vaaane/horta-inteligente/(commit log)

2026-09-28 Adiciona clima do Open-Meteo: ESP32 -> Firebase -> site
    - teste-acende.ino reorganizado em funções, sem delay(), e consulta
    o Open-Meteo a cada 30 min (5 min se falhar), gravando em /clima
    - Cartão "Clima agora" na teste.html
    - Regras: nó /clima (leitura e escrita abertas, com validação)
2026-09-28 Corrige aviso de formato no log de heap do clima
    [teste-acende.ino]
2026-09-28 Adiciona LEDs de status (Wi-Fi, Firebase, Clima) no teste-acende
    LEDs nos GPIO 25, 26 e 27 com 4 estados (apagado, pisca lento,
    aceso, pisca rápido), piscando com millis() e teste de 1 s no boot.
2026-09-28 Adiciona botão físico do LED e log detalhado de erro do Firebase
    - Botão no GPIO 32 (INPUT_PULLUP, debounce de 50 ms) alterna o LED
    do site e grava em /teste/led; sem Wi-Fi fica pendente e reenvia
    a cada 10 s, sempre o último estado
    - Serial e botão usam o mesmo atualizarLed()
    - gravarNoFirebase() mostra caminho, código e motivo do erro;
    o log do clima mostra o código HTTP
2026-09-29 Leva o cartão Clima agora para o painel (módulo clima.js)
    O código do cartão sai do teste.html e vai para web/clima.js, usado
    nas duas páginas. No painel aparece a faixa informativa de chuva alta
    (>= 60%) e a mensagem de previsão indisponível quando /clima está vazio.
2026-09-29 Adiciona a página Sobre o projeto
    Abertura, fluxo Sensores -> ESP32 -> Firebase -> Painel, cartões de
    funcionalidades gerados a partir de uma lista em sobre.js, tabela de
    materiais e custos, evolução do projeto e seção da equipe.
2026-09-29 Adiciona QR code "Abra no seu celular"
    Gerado no navegador com qrcode-generator (versão fixa no jsDelivr),
    em SVG. No painel só aparece em telas a partir de 1024px; na página
    Sobre aparece sempre, no fim da página.
2026-09-29 Ajusta o painel para tela grande e projetor
    A partir de 1400px: letras maiores, painel com até 1400px de largura e
    umidade, bomba, clima e QR numa linha só. Entre 1024 e 1399px os quatro
    cartões ficam dois por linha.
2026-09-29 Ajusta o painel: clima mais largo, endereço no QR e cartões vazios
    - Cartão Clima agora: valor e unidade não quebram (unidade em <small>),
    rótulos curtos e, a partir de 1024px, cartão largo com os 4 valores
    numa linha.
    - QR code mostra o endereço por extenso; em localhost ou arquivo local
    mostra um aviso no lugar.
    - Umidade e bomba mostram "Aguardando o ESP32…" até chegar o 1º dado.
2026-09-29 Regras: decisão e motivo no estado e histórico em horta/decisoes
    - horta/estado aceita os campos opcionais decisao (lista fechada de
    códigos) e motivo (até 160 caracteres).
    - horta/decisoes: histórico, escrita só do ESP32, indexado por ts.
    - /teste e /clima continuam iguais.
2026-09-29 Firmware da horta: previsão de chuva na decisão da rega
    - Traz do teste-acende a consulta ao Open-Meteo (30 min, 5 min se
    falhar) e grava em /clima com o login do ESP32. Não consulta com a
    bomba ligada, para não atrasar a segurança do tempo máximo.
    - controlarBomba() agora calcula um código de decisão e um motivo em
    português: adia a rega com chance de chuva >= 60%, rega mesmo assim
    com solo abaixo de 20% e rega só pelo sensor sem previsão válida.
    - Envia decisao/motivo em /horta/estado e registra cada mudança de
    código em /horta/decisoes (fila de um item se estiver sem Wi-Fi).
    - SIMULAR_CHANCE_CHUVA para testar em casa.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
2026-09-29 Painel: cartão "Por que regou (ou não)"
    Novo módulo web/decisao.js (mesmo padrão do clima.js): mostra o ícone e
    o motivo da decisão atual do ESP32 em letra grande e as 5 últimas
    decisões de horta/decisoes ("hoje 17:05", "ontem 06:40"). O cartão
    fica escondido se o estado não tiver decisão (firmware antigo).
    Na página Sobre, "Adiar a rega se vai chover" e "Motivo de cada
    decisão" passam para Funcionando.
2026-09-29 Firmware: comandos a cada 3 s, limite de 10 min no manual e Wi-Fi mais estável
    - Montagem de teste com LED no lugar do relé e potenciômetro no lugar do sensor
    - Lê /horta/comandos a cada 3 s reaproveitando a conexão HTTPS com o banco
    - Envia o estado na hora quando a bomba ou a decisão mudam
    - Modo manual volta sozinho para o automático depois de 10 min
    - Wi-Fi: reconexão automática, 30 s antes de recomeçar e motivo das quedas
2026-09-29 Painel: controle da bomba (Automático | Manual e Ligar/Desligar)
    - Módulo novo web/controle.js dentro do cartão "Bomba d'água"
    - O círculo continua mostrando o estado real enviado pelo ESP32
    - Aviso de pedido pendente, sem resposta em 15 s e pausa de segurança
    - Contagem regressiva do modo manual e botões desativados com o ESP32 offline
2026-09-29 README e Sobre: controle pelo site e montagem de teste com LED e potenciômetro
2026-09-29 Regras: UID do ESP32
2026-09-29 Firmware: comandos por streaming e envios mais rápidos
    - Comandos do site por streaming (Server-Sent Events) numa conexão só para
    isso, lida sem travar o loop(); plano B com polling a cada 1 s
    - Sensor a cada 300 ms no MODO_TESTE
    - Estado na hora quando a bomba, a decisão ou a umidade (2 pontos) mudam,
    no máximo 1 por segundo, e a cada 5 s sem mudança
    - Histórico a cada 10 s no MODO_TESTE; campo modoTeste no estado
    - Serial mostra o motivo de cada acionamento e cada comando recebido
2026-09-29 Painel: modo teste, resposta em 5 s e legenda do pedido
    - Offline depois de 20 s sem estado no modo teste (2 min no normal)
    - "O ESP32 não respondeu" depois de 5 s
    - Selo "Modo teste" e sem contagem do manual quando o ESP32 avisa
    - Legenda "Você pediu: ligada/desligada" abaixo do botão
    - README: seção sobre o MODO_TESTE e o streaming
2026-09-29 Firmware: LEDs de status e bomba no GPIO 33
2026-09-29 Firmware: corrige LEDs de status do Wi-Fi e do Firebase
    - DEBUG_LEDS: mostra no Serial cada mudança de LED e, a cada 5 s, o estado
    guardado, o nível real do pino (GPIO.out) e a volta mais lenta do loop()
    - Confere se os GPIO 25/26 continuam como saída digital (não RTC/DAC) e
    reconfigura se algo mexeu neles
    - LEDs fixos têm o pino reescrito a cada 0,5 s
    - Estado dos LEDs sincronizado depois do teste de 1 s do setup()
    [esp32-horta.ino]
2026-09-29 Firmware: modo demonstração (chance de chuva simulada pelo site)
    - Lê simularChuva de /horta/comandos no streaming e no plano B
    - Prioridade: simulação do site, SIMULAR_CHANCE_CHUVA, previsão real;
    motivo termina com "(simulado)"
    - Decide e envia o estado na hora quando a simulação muda
    - No automático, para a rega se a chuva ficar provável (adiada_chuva)
    - Fora do MODO_TESTE a simulação expira em 15 min
    - gravarModoAutomatico usa PATCH para não apagar a simulação
2026-09-29 Painel: cartão Modo demonstração (simular chuva)
    - Módulo novo web/demo.js, acima do "Por que regou (ou não)"
    - Chave Simular chuva, controle de 0 a 100% (grava ao soltar), botões
    rápidos e marcação em 60%
    - Faixa âmbar com "Voltar à previsão real" e linha no cartão do clima
    - Controles desativados com o ESP32 offline
2026-09-29 Firmware: registra cada rega em /horta/regas (água estimada)
    - VAZAO_L_MIN = 1,5 L/min (estimativa; comentário de como medir)
    - Ao desligar a bomba: segundos, litros, motivo e inicio/fim pelo relógio
    do Firebase (vem no ts de cada envio do estado)
    - Fila de até 5 regas para quando estiver sem Wi-Fi
    - Regas com menos de 1 s não são registradas
2026-09-29 Regras: horta/regas (escrita do ESP32) e horta/config/inicioMedicao (aberto)
2026-09-29 Painel: cartão Água (usada e economizada, estimativa)
    - Módulo novo web/agua.js, abaixo do gráfico
    - Água usada, quanto um timer fixo teria usado e a economia (L e %),
    traduzida em banhos e garrafões; diferença negativa mostrada com honestidade
    - Selo Estimativa, rega em andamento com o tempo correndo, 10 últimas regas
    - Zerar contagem com confirmação no próprio cartão (horta/config/inicioMedicao)
    - decisao.js exporta quando() para o formato das datas
2026-09-29 Painel: água ao vivo em passos de 0,5 L
    - A rega em andamento soma na Água usada a cada segundo; ao terminar, fica
    na conta até o registro chegar em /horta/regas (sem pular nem contar duas vezes)
    - Litros na tela arredondados para baixo ao meio litro (Água usada, timer,
    economia, banhos e garrafões); no Firebase continuam com 2 casas
    - Timer fixo começa na primeira rega, fechada ou em andamento
    - "N regas + 1 em andamento"
    - Firmware manda regaDesde no estado (hora do servidor em que a bomba ligou);
    regras liberam o campo
    [esp32-horta.ino]
2026-09-29 Firmware e regras: resumo diário da água em /horta/agua/dias
    - Hora certa por NTP (Brasília); horaValida() e dataHoje()
    - Cada rega soma litros, segundos e regas no dia (PATCH com os totais);
    ET0 do dia vinda do Open-Meteo
    - Ao ligar e ao trocar de dia, lê o dia para continuar de onde parou
    - Rega que atravessa a meia-noite conta no dia em que terminou
    - Regras: horta/agua/dias/$dia (AAAA-MM-DD), escrita só do ESP32
2026-09-29 Painel: água por dia (gráfico e tabela)
    - Gráfico de barras no cartão Água: usado pela horta, timer fixo e
    recomendado pela ET0 (et0 × AREA_M2 = 0,25 m²), com 7 | 14 | 30 dias
    - A barra de hoje soma as regas de hoje e a rega em andamento, ao vivo
    - Frase-resumo do período (economia negativa dita com honestidade)
    - Tabela recolhível por dia com rolagem própria; valores de 0,5 em 0,5 L
    - Dias sem registro contam 0 L de uso (o timer continua contando)
2026-09-29 Regras: horario_quente nas listas de decisão, simularHora e estado/hora
2026-09-29 Painel: simular horário, ícone do sol forte e hora da horta
    - Modo demonstração: chave Simular horário (0 a 23 h, grava ao soltar),
    faixa laranja "sol forte" das 10h às 16h, botões 07h, 12h e 17h e faixa
    âmbar com Voltar ao horário real; demo.js monta as duas simulações a
    partir de uma configuração
    - Ícone ☀️ para horario_quente
    - "Hora da horta: 14h (simulada)" no cabeçalho do painel
    - Sobre: Horário inteligente -> Funcionando
2026-09-29 Regras: cota_atingida nas listas de decisão, zerarCotaEm e cota no estado
2026-09-29 Painel: barra da cota pela ET0, recomeçar a cota e ícone 🎯
    - Cartão Água: "Cota de hoje pela ET₀" com barra de progresso (sobe ao
    vivo com a bomba ligada) e a conta ET₀ × área × Kc
    - Modo demonstração: botão Recomeçar a cota (demo) -> zerarCotaEm
    - Ícone 🎯 para cota_atingida
    - Sobre: Quanto regar pela ET₀ -> Funcionando
2026-09-29 Firmware: cota desconta a chuva que caiu
    - Open-Meteo: precipitation_sum do dia -> chuvaHojeMm (também em /clima)
    - cota = max(0, ET0 × Kc − chuva) × área
    - Com cota 0 pela chuva: "Choveu X mm hoje: mais que a planta perdeu."
    - Regras de /clima aceitam chuvaHojeMm
2026-09-29 Firmware: margem extra de até 50% quando o solo continua seco
    - MARGEM_EXTRA = 0,5: com a cota atingida e o solo ainda precisando de
    água, libera rega extra (decisão nova cota_extra) até cota × 1,5
    - Passou da margem: cota_atingida pedindo para conferir sensor e canteiro
    - litrosExtra (acima da cota) guardado no resumo do dia e lido ao ligar
    - et0Pendente vira resumoPendente
2026-09-29 Firmware: detecção de falha (regou e a umidade não subiu)
    - Depois de 45 s de rega automática, a umidade tem que ter subido 3 pontos;
    senão desliga, entra em falha (decisão nova falha_agua) e registra
    - Em falha o automático não liga, nem com solo crítico; o manual obedece
    - Sai pelo "Já resolvi" do site (resetFalhaEm) ou se a umidade subir 10 pontos
    - Chave detectarFalha do site (ausente = ligada) para as demonstrações
    - emFalha no estado e em /horta/agua/ajuste (vale depois de reiniciar)
    - Ordem da decisão comentada no código (1 a 10)
    [esp32-horta.ino]
2026-09-29 Firmware: aprende com os dias (ajuste do Kc)
    - KC vira o valor inicial; o kc em uso fica em /horta/agua/ajuste
    (kc, motivo, atualizadoEm) e é lido ao ligar
    - Na virada do dia: usou margem extra sem falha -> kc + 0,1 (teto 1,5);
    usou menos de 70% da cota sem crítico nem falha -> kc - 0,05 (piso 0,6)
    - Resumo do dia grava kc, cota, chuvaMm e litrosExtra
    - simularFimDiaEm do site aplica o ajuste com os números de hoje e
    recomeça a cota
2026-09-29 Regras: cota_extra e falha_agua, comandos da falha e do Kc, ajuste e campos do dia
    - cota_extra e falha_agua em todas as listas de decisão
    - horta/comandos: resetFalhaEm, simularFimDiaEm (<= now) e detectarFalha
    - horta/estado/emFalha
    - horta/agua/ajuste (só o ESP32): kc 0,6 a 1,5, emFalha, atualizadoEm, motivo
    - horta/agua/dias aceita kc, cota, chuvaMm e litrosExtra
2026-09-29 Painel: margem extra, Kc aprendido, falha e fim do dia simulado
    - Barra da cota até 150%: verde até a cota, margem extra listrada; a conta
    (ET₀ × Kc − chuva) × área e a linha do Kc (ajustado quando e por quê)
    - Faixa vermelha de falha no topo e no cartão da bomba, com Já resolvi
    (módulo novo web/falha.js)
    - Ícones ⚠️ (falha_agua) e ➕ (cota_extra)
    - Modo demonstração: Simular fim do dia e a chave Detectar falha
    - Gráfico: barra da ET₀ usa a cota salva no dia; a dica mostra ET₀, chuva e Kc
    - Sobre: Detecção de falhas -> Funcionando
2026-09-29 Firmware: corrige conexão Wi-Fi (motivo 3)
    - A autocorreção dos LEDs não reconfigura mais o GPIO 25/26 pelo RTC/DAC
    (rtc_gpio_deinit a cada 0,5 s): são pinos do ADC2, usado pelo Wi-Fi.
    Agora só avisa no Serial; a reescrita do nível a cada 0,5 s continua
    - configTime (NTP) só depois que o Wi-Fi conecta
    [esp32-horta.ino]
2026-09-29 Firmware: explica o motivo 3 de queda do Wi-Fi
2026-09-29 Firmware: histerese no solo crítico
    - Crítico entra abaixo de 20% e só sai acima de 25% (emCritico); entre
    20% e 25% continua regando com motivo próprio; depois de sair, a cota ou
    a margem que parou a rega não recomeça por oscilação de 1 ponto
    - Umidade com média móvel das últimas 5 leituras
    - Decisão automática não troca o estado da bomba mais de uma vez a cada 3 s
    (manual, falha e comandos do site continuam na hora)
    - Histórico: decisão só vai para /horta/decisoes depois de 10 s estável;
    A→B→A em menos de 10 s não gera entradas
2026-09-29 Planeje sua horta: desenho do terreno
    - Página nova web/planejar.html e link na navegação do painel e da Sobre
    - web/planejar.js: terreno em escala num canvas (régua e grade de 1 m,
    nítido em telas de alta densidade), seta do norte que gira (arrastando ou
    pelo controle), local (latitude/longitude)
    - Obstáculos retângulo (muro, casa) e círculo (árvore) com altura: adicionar,
    arrastar com mouse ou dedo (Pointer Events), editar e excluir no painel
    - Exemplo pronto (muro de 2 m no norte, árvore de 4 m no leste), salvamento
    no localStorage e Começar do zero
2026-09-29 Planeje sua horta: mapa de horas de sol
    - web/sol.js: cálculo puro (quadradinhos de 0,25 m, maiores acima de ~4000),
    posição do sol pelo SunCalc a cada 30 min do nascer ao pôr, conversão do
    azimute do SunCalc (a partir do sul) para o desenho, sombra por interseção
    com retângulos e círculos (altura > d × tan(altitude)), ano todo = menor valor
    - Mapa de calor com legenda (sombra, meia-sombra, pleno sol) em cores boas
    para daltônicos; dica "5,5 h de sol" com mouse ou toque
    - Datas: dia escolhido, Hoje, Verão, Inverno, Equinócio e Ano todo (pior caso)
    - Recalcula sozinho com um pequeno atraso; mostra "calculando…" se demorar
    - web/sol.test.mjs: testes em Node (node web/sol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
2026-09-29 Planeje sua horta: plantas e o melhor lugar para cada uma
    - web/culturas.js: sol e umidade de referência de 11 plantas e a escolha do
    lugar (as mais exigentes primeiro, região contínua crescendo a partir do
    melhor ponto, meia-sombra evita gastar os pontos de pleno sol)
    - "O que você quer plantar?" com a área de cada planta; regiões coloridas
    com o nome no mapa e explicação em texto (lado, horas de sol, falta de sol
    ou de espaço), respeitando a data ou o ano todo
    - Tabela "Umidade e sol por cultura" com a explicação de pleno sol,
    meia-sombra e sombra
    - Teste da sugestão em web/sol.test.mjs
2026-09-29 Planeje sua horta: Sobre e README
    - Sobre: Desenhe sua horta, Mapa de horas de sol, Melhor lugar para cada
    planta e Umidade e sol por cultura -> Funcionando; Sol suficiente ou não e
    Previsto × medido continuam Próxima etapa, com a nota do cálculo já pronto
    - README: seção Planeje sua horta (o cálculo em 4 passos e o roteiro da
    feira) e os arquivos novos na lista
2026-09-29 Planeje sua horta: mapa de satélite
    - Módulo novo web/mapa.js: Leaflet 1.9.4 (cdnjs) com as imagens Esri World
    Imagery (sem chave), maxNativeZoom 19 e maxZoom 21, atribuição da Esri e
    camada de nomes de ruas opcional; começa em São Sebastião (DF), zoom 17
    - Busca de endereço pelo Nominatim (uma busca por clique, com atribuição)
    e "Usar minha localização" com mensagem clara se a pessoa negar
    - Alternância Sobre o mapa | Desenho livre no topo da página
    - Desenho livre não mede nem desenha enquanto está escondido
2026-09-29 Planeje sua horta: desenhar sobre o mapa
    - Terreno desenhado no mapa (clicar e arrastar, ou um toque para 6 × 4 m),
    com alças para redimensionar, mover e girar, e as medidas em metros
    - Obstáculos: casa ou muro (retângulo, com giro) e árvore (círculo); tipos
    sugeridos casa térrea 3 m, sobrado 6 m, muro 2 m e árvore média 5 m
    - Gestos próprios com mouse ou dedo: o mapa só anda quando o toque começa
    fora dos desenhos e sem ferramenta
    - Mesmo painel de edição do Desenho livre; no mapa o norte é sempre para
    cima (rosa dos ventos fixa) e o cálculo usa o centro do terreno
    - Ajuda da ferramenta por cima do mapa, sem empurrar a página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
2026-09-29 Planeje sua horta: cálculo e mapa de calor sobre o satélite
    - O desenho do mapa vira metros num plano local centrado no terreno
    (1° de latitude ≈ 111 320 m; longitude × cos(latitude)); a grade segue o
    terreno mesmo girado, e o giro do terreno vira o ângulo do norte do plano
    - sol.js: campo opcional angulo nos retângulos (casas giradas em relação ao
    terreno); sem ele a conta é a mesma. Teste novo em sol.test.mjs
    - Mapa de calor semitransparente só dentro do terreno (opacidade de 30% a
    90%), mesma legenda, dica "5,5 h de sol" com mouse ou toque
    - Regiões sugeridas para cada planta desenhadas sobre o mapa com o nome;
    datas, ano todo, plantas e textos iguais ao Desenho liv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
2026-09-29 Planeje sua horta: salvar e compartilhar
    - Salva no navegador (localStorage, em try/catch) o modo, o centro e o zoom
    do mapa, o terreno e os obstáculos
    - Copiar link: o desenho (e as plantas marcadas) vai no endereço (#p= com
    JSON compacto em base64); quem abre vê a mesma horta. Sem permissão para
    copiar, mostra o link para copiar à mão
    - Carregar exemplo no modo mapa: terreno 6 × 4 m no centro do mapa, muro de
    2 m no norte e árvore de 5 m no canto leste
    - A página abre no modo Sobre o mapa (Desenho livre se o mapa não carregar)
2026-09-29 Planeje sua horta: textos do modo mapa
    - Explicação na página: o cálculo pela posição do sol a cada 30 minutos,
    a sombra pela altura dos obstáculos e para que serve a imagem de satélite
    - README: seção do modo Sobre o mapa, com as atribuições (Esri,
    OpenStreetMap/Nominatim, Leaflet) e o roteiro da feira
2026-09-29 Planeje sua horta: arrastar a região de cada planta
    - Módulo novo web/plantas.js (os dois modos usam o mesmo código): cada
    planta vira um canteiro retangular alinhado à grade, com a área escolhida
    - Arrastar pela região ou pelo nome (mouse e dedo); ao soltar, encaixa na
    grade; no modo mapa o mapa não anda enquanto a planta é arrastada
    - Botão ↻ gira 90° (tenta um pouco para os lados se não couber)
    - Fora do terreno ou sobre obstáculo: cinza tracejado com "Aqui não dá";
    ao soltar num lugar inválido, volta para o último lugar válido
    - culturas.js: tamanho do canteiro (área exata quando dá, ex. 4 × 2),
    validação, melhor posição e sugestão; avaliação do lugar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
2026-09-29 Planeje sua horta: avaliação ao vivo de cada planta
    - Canteiro pintado pela avaliação do lugar (verde Recomendado, amarelo
    Aceitável, vermelho Não recomendado), com borda e preenchimento
    semitransparente e o ícone ✓ ! ✕ junto do nome
    - Balão de texto durante o arraste e na planta tocada, ex.: "Tomate aqui:
    4,5 h de sol (mín. 2,5 h). Precisa de 6 h ou mais. Não recomendado.";
    meia-sombra também avisa quando passa do máximo
    - Reavalia quando mudam a data (ou ano todo), os obstáculos e o terreno
    - Lista com o selo da avaliação, as horas de sol e o lugar; se nem o melhor
    lugar serve, explica o que fazer
2026-09-29 Planeje sua horta: convivência entre plantas
    - Sobreposição: contorno vermelho nas duas regiões e o aviso "Tomate e
    Alface estão no mesmo lugar." (também ao vivo durante o arraste)
    - Rega: vizinhas a menos de 0,5 m com faixas de umidade sem parte em comum
    (encostar só na borda também conta) ganham uma dica amarela, sem mudar a
    cor da avaliação de sol
2026-09-29 Planeje sua horta: nomes legíveis, botões e resumo das plantas
    - Região pequena na tela (lado menor que ~40 px) ou lugar já ocupado: o nome
    sai para fora com uma linha fina, testando posições em volta até achar uma
    livre (os nomes não se sobrepõem mais)
    - Botões Voltar à sugestão (planta selecionada) e Sugerir de novo (todas)
    - Mostrar só as áreas boas para…: pinta de verde os pontos recomendados
    para a planta escolhida (cinza no resto), nos dois modos
    - Resumo acima da lista: "3 plantas recomendadas, 1 aceitável, 1 não
    recomendada."
    - Medidas dos canteiros arredondadas (sem 1.2000000000000002)
2026-09-30 Planeje sua horta: desenho da planta
    - planta.js desenha a planta num canvas próprio, sem a imagem de satélite:
    terreno em escala com o norte para cima (girado se estiver girado no mapa),
    grade de 1 m, medidas nos lados, mapa de horas de sol, obstáculos com nome
    e altura, plantas com a cor e o ícone da avaliação (nomes fora com linha),
    rosa dos ventos, escala gráfica, cabeçalho, legenda e rodapé
    - legenda e mapa com padrões (sombra hachurada, meia-sombra pontilhada) para
    imprimir em preto e branco
    - convivência entre plantas separada em convivenciaEntre(), usada também
    pela planta
2026-09-30 Planeje sua horta: Minhas hortas
    - campo "Nome do projeto" (padrão "Minha horta"), usado no título da
    planta e no nome dos arquivos
    - "Salvar projeto" guarda no navegador uma lista de projetos (nome, data,
    todos os dados e uma miniatura); com o mesmo nome, atualiza
    - lista "Minhas hortas" com miniatura, nome e data, e os botões Abrir,
    Renomear, Duplicar e Excluir (com confirmação na própria linha)
    - projetos salvos e arquivos guardam as coordenadas sem arredondar:
    abertos de novo, as horas de sol e as avaliações ficam iguais
2026-09-30 Hortas na nuvem: regras do Firebase
    - /hortasPlanejadas: ninguém lista todas as hortas (.read false); quem sabe
    o código abre e altera a sua
    - código no formato certo, nome de 1 a 60 caracteres, dados até 300000,
    datas não podem estar no futuro, editor até 40, arquivada booleana,
    versões só nas gavetas "0" a "9", nenhum campo a mais
    - não dá para apagar: ".write" exige newData.exists() (o Firebase não roda
    ".validate" quando o dado é apagado, por isso a condição fica no .write)
2026-09-30 Hortas na nuvem: salvar, abrir e continuar
    - "Salvar na nuvem": na primeira vez cria o código e mostra um quadro com
    o código grande, o link (planejar.html?h=...), o QR code, o botão Copiar
    e o aviso "Anote este código..."; depois salva na mesma horta
    - salvamento automático 3 s depois de parar de mexer, com o indicador
    (Salvo na nuvem ✓ / Salvando… / Sem conexão: envio quando voltar)
    - histórico: uma versão a cada "Salvar" e a cada 5 min de edição (as 10
    últimas); restaurar guarda antes a atual, para poder desfazer
    - abrir pelo campo "Tenho um código" ou pelo link ?h=; código que não
    existe mostra "Não encontrei uma horta com esse código."
    - edição ao mesmo t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
2026-09-30 Hortas na nuvem: Minhas hortas com códigos
    - a lista deste aparelho guarda códigos: nome, código, último acesso e
    miniatura de cada horta criada ou aberta aqui (a aberta fica destacada)
    - botões Abrir e Tirar da lista (só esquece o código neste aparelho; a
    horta continua na nuvem)
    - aviso: "Esta lista fica só neste aparelho. Em outro aparelho, abra pelo
    código ou link."
    - projetos antigos, salvos só no navegador, aparecem à parte com
    "Enviar para a nuvem" (cria um código para cada um), Abrir e Excluir
    - sai o botão "Salvar projeto" local; Copiar link e Arquivo do projeto
    continuam
2026-09-30 Planeje sua horta: histórico de versões mais claro
    - não grava versão igual à mais recente (salvar manual, automática de
    5 min e "antes de restaurar")
    - no máximo uma versão por minuto pelo "Salvar na nuvem": outro clique
    dentro de 60 s troca a versão desse minuto
    - cada versão guarda um resumo ("Terreno 6 × 4 m · 2 obstáculos ·
    3 plantas (...)") com o que mudou ("+ Pimenta", "Tomate movido",
    "− Árvore", "Terreno redimensionado") e o tipo (salva por você,
    automática, antes de restaurar); regras liberam resumo e tipo
    - lista "Versões desta horta": linha "Atual" no topo, data com segundos,
    etiqueta, frase explicando que são da mesma horta (com o código) e a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
2026-09-30 Planeje sua horta: arquivo .json vira backup no menu
    - sai o botão "Abrir arquivo" da barra principal; entra "Abrir pelo
    código", que mostra o campo do código (o mesmo de antes, sem duplicar)
    - menu "Salvar planta ▾": Imagem (PNG), Imprimir / PDF e, na parte
    "Backup", Baixar backup (.json) e Abrir backup (.json), com a ajuda
    "Backup é uma cópia da horta no seu computador..."
    - abrir backup com uma horta da nuvem aberta pergunta: horta nova (sem
    código, o padrão) ou substituir a atual (que vai para o histórico)
    - textos: "Arquivo do projeto" vira "backup" (tela e README)
2026-09-30 Telegram: fila e envio
    - sendMessage (HTML, sem prévia de link) para cada chat id da lista,
    numa conexão própria (abre, envia, fecha), timeout de 8 s
    - fila de até 8 mensagens (a mais antiga sai se encher); o loop() envia
    uma por vez, no máximo a cada 3 s: quem decide só põe na fila
    - sem Wi-Fi a fila espera; mensagem com mais de 10 min é descartada
    - 429 respeita o retry_after; 400/401/403 avisam no Serial e desligam o
    Telegram até reiniciar; erro de rede tenta de novo em 30 s
    - pouca memória para mais uma conexão segura: espera
2026-09-30 Telegram: quais mensagens
    - avisos pela decisão estável (a que vai para /horta/decisoes depois de
    10 s): rega começou, adiada/interrompida (🌧️ ☀️ 🎯), solo crítico,
    falha, manual e volta ao automático
    - rega terminou (tempo e litros); rega de menos de 20 s vira uma
    mensagem só ("💧 Regou 15 s")
    - falha resolvida, placa ligada e resumo do dia na virada (regas,
    litros, cota, Kc antes → depois e o timer fixo de comparação)
    - MODO_TESTE: só os importantes, a não ser com
    TELEGRAM_TUDO_NO_MODO_TESTE
    - anti-spam: a mesma mensagem (evento + código) não se repete antes de
    60 s; motivos escapados para HTML; link do painel no fim
    - README: tabela das mensagens e r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
    [esp32-horta.ino]
2026-09-30 Telegram: aviso de horta sem sinal como próxima etapa
    - README: passos para um Worker separado com Cron Trigger (5 min) que
    lê horta/estado/ts e avisa uma vez "sem sinal" e depois "voltou",
    com o estado num KV e o token em secret do Worker
    - não implementado agora: precisa criar e publicar Worker e KV novos
    na conta do Cloudflare
2026-09-30 Telegram: "Alertas no celular" funcionando no site
    - sobre.js: status muda de "próxima" para "funcionando"
    - nada do token nem dos chat ids vai para o site
2026-09-30 Pode regar agora: semáforos no estado
    - /horta/estado passa a mandar o que a decisão considerou: emCritico,
    chanceUsada (-1 sem previsão), chuvaSimulada, horaSimulada,
    cotaLimite (cota + margem extra), detectarFalha e bloqueio
    - bloqueio: o que impediria a rega agora se o solo precisasse
    ("", falha, chuva, horario, cota, chuva_caiu), na mesma ordem de
    controlarBomba() e sem contar o solo crítico
    - o estado vai na hora quando o bloqueio muda
    - regras: campos novos opcionais, com tipos e faixas
2026-09-30 Pode regar agora: faixa no topo do painel
    - web/podeRegar.js: faixa logo abaixo dos cartões do topo, acima do
    Modo demonstração
    - linha 1, a resposta: modo manual, regando agora, não precisa regar,
    "⛔ Não vai regar — (bloqueio)", "🚨 Regando mesmo assim — solo
    crítico… Sem o crítico, a chuva impediria." e "Sem dados do ESP32"
    - linha 2, os semáforos (solo, chuva, horário, cota, falha) com ícone,
    valor, cor e "(simulado)"; o que bloqueia vai primeiro, com borda
    grossa; tocar num chip mostra a explicação de uma linha
    - botão ao lado do bloqueio: Recomeçar a cota (demo), Já resolvi ou
    Voltar ao real, usando as funções de demo.js e falha.js
    - o site não re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
2026-09-30 Pode regar agora: legível no projetor e no celular
    - celular: chips em duas colunas, o texto quebra em vez de ser cortado;
    o botão de ação ocupa a linha inteira
    - projetor (≥ 1400px): resposta e chips maiores
    - estado nunca só pela cor: ícone e texto sempre visíveis, e o leitor
    de tela ouve "liberado/atenção/bloqueando"
2026-09-30 Site: canal do Telegram (QR no projetor, botão no celular)
    - web/config.js: CANAL_TELEGRAM, o único lugar com o link do canal
    (só o link público; nada de token ou chat id no site)
    - painel, tela grande: cartão "Abra no seu celular" com dois QR lado
    a lado (📱 Abrir o painel e 🔔 Receber alertas), ocupando 2 colunas;
    o do canal aparece até no localhost
    - painel, celular: botão "🔔 Receber alertas no Telegram" logo abaixo
    da faixa "Pode regar agora?", com a frase sobre o canal
    - Sobre: "Entrar no canal" e QR pequeno (tela grande) no item
    "Alertas no celular"
    - rodapé de todas as páginas: "Alertas no Telegram"
    - qr.js: o endereço embaixo do QR pode quebrar depois da "/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
2026-10-01 Painel: cabeçalho compacto
    - uma linha só nas 3 páginas: 🌱 Horta Inteligente e a escola em texto
    pequeno à esquerda, navegação à direita (de ~170 px para ~60 px)
    - "Hora da horta" vira uma pílula ao lado do nome ("🕐 15h")
    - celular (≤ 600 px): a navegação vira o botão ☰ (cabecalho.js, com
    aria-expanded; Esc e toque fora fecham). Sem JavaScript a lista
    continua visível
2026-10-01 Painel: abas
    - abas Agora · Água · Histórico · Demonstração (abas.js), cada uma com
    endereço próprio (#agora, #agua, #historico, #demo); trocar de aba
    muda o hash sem recarregar; role=tablist/tab/tabpanel, setas e
    Home/End; os módulos continuam todos ligados com a aba escondida
    - Agora: faixa "Pode regar agora?" no topo (QR ao lado no computador),
    4 cartões (umidade com tracinhos em liga 35% / desliga 60%, bomba,
    clima compacto e o novo "Água economizada", que abre a aba Água) e a
    linha "Última decisão, 11:31: … ver histórico"
    - o motivo grande repetido sai: "Últimas decisões" vai para o Histórico
    - Água: "Em coisas do dia a dia" em linhas separadas, sem "0,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
2026-10-01 Painel: modo projetor
    - projetor.js: com ?tela=projetor ou o interruptor da aba Demonstração
    (guardado no localStorage), alterna Agora → Água → Histórico a cada
    20 s; a Demonstração nunca entra na rotação
    - fica parado na aba Agora enquanto há falha, a bomba está ligada ou a
    decisão acabou de mudar (30 s); um toque, clique ou tecla pausa por
    2 min
    - três pontinhos discretos no canto mostram a aba no ar (laranja =
    pausado)
    - para caber sem rolar a partir de 1024 px: cartões mais justos, aba
    Água em duas colunas (números e gráfico por dia), Histórico com o
    gráfico e as decisões lado a lado; no projetor em 720 p, gráficos
    mais baixos e sem as notas pequen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
2026-10-01 Painel: correções visuais
    - pílula "Desligada/Ligada 💧" da bomba limitada à largura do cartão
    (max-width e quebra; fonte menor na tela grande)
    - títulos dos cartões numa linha só: menos espaço entre letras e fonte
    menor na fileira de 4 cartões
    - cartões da mesma fileira com a mesma altura e o conteúdo no topo
    - rodapé do painel e do Planeje sua horta sem o link "Página de teste"
    (teste.html continua no endereço direto)
2026-10-01 Painel: canal do Telegram no lugar do QR do site
    - quem olha o projetor já está vendo o site: o cartão "Abra no seu
    celular" vira "Receba os alertas da horta", com o QR do canal, a
    frase "Avisos de rega, falha e reservatório no seu celular" e o @ do
    canal; no celular, o botão "Abrir canal no Telegram" no lugar do QR
    - config.js: TELEGRAM_CANAL (antes CANAL_TELEGRAM) é o único lugar com
    o link; vazio, o cartão e os links do canal não aparecem
    - o QR do site continua só na página Sobre
    - modo projetor: o pontinho acompanha a aba na mesma hora da troca; em
    720 p a faixa, os chips e os números da aba Agora ficam um pouco
    menores para caber sem rolar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
2026-10-01 Painel: README
    - seção "O painel": abas e o #hash de cada uma, quem pode mexer
    (tela grande ou ?demo=1), modo projetor (?tela=projetor)
    - Alertas no Telegram: "Canal da horta" (criar o canal, bot como
    administrador, chat id negativo em TELEGRAM_CHAT_IDS, link em
    TELEGRAM_CANAL, link do site na descrição do canal e a dica de ligar
    TELEGRAM_TUDO_NO_MODO_TESTE durante a feira)
    - arquivos novos do site; teste.html citada só aqui (sem link no site);
    textos que falavam do cartão "Por que regou (ou não)"
2026-10-01 Painel: tamanhos
    - tamanhos centralizados no :root (--fs-gigante, --fs-numero,
    --fs-bomba, --fs-titulo, --fs-texto, --fs-nota, --espaco-cartao,
    --gap) e usados no painel, no Planeje e no Sobre
    - os grandes (resposta da faixa, umidade, litros, temperatura, QR)
    usam clamp(): crescem no projetor de 1920 e encolhem em 1280
    - texto pequeno (rótulos, notas, "Atualizado às…") com 14 px ou mais
    a partir de 1024 px
    - sai o html { font-size: 20px } do projetor, que aumentava tudo por
    igual, e os ajustes soltos por resolução
    - no computador: botões Automático/Manual e chips da faixa mais baixos,
    menos espaço dentro e entre os cartões
    - a aba Agora cabe sem rolar em 1366×768 e 128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
2026-10-01 Painel: aba Agora
    - tempo.js: os tempos do site escritos de um jeito só ("há 12 s",
    "há 5 min", "há 18 h", "ontem às 14:48", "há 3 dias"; nas listas,
    "hoje 13:54", "ontem 13:54", "seg 28 13:54"); acabou o "há 1115 min"
    - aviso de offline com o tempo real ("ESP32 sem sinal há 18 h"), igual
    ao rodapé; os 20 s / 2 min continuam decidindo quando ele aparece
    - sem sinal, a faixa "Pode regar agora?" vira uma linha: "Sem sinal do
    ESP32 há 18 h: a decisão volta quando ele reconectar."
    - cartão da bomba sem sinal: "Sem sinal: controle pausado" e botões
    desativados mais baixos
    - clima: "Atualizado ontem 14:38" e "Clima sem atualizar há 18 h"
    - "Água economizada": "desde <iníc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
2026-10-01 Água: um período só
    - seletor único no topo da aba: Desde o início · 7 dias · 30 dias
    (padrão: Desde o início); ele muda a frase, os 3 números, as
    equivalências, o gráfico, a tabela por dia e as últimas regas
    juntos. Ao lado, "medindo há 3 dias" ou "3 dias sem medição não
    entram na conta". Sai o seletor 7/14/30 do gráfico
    - timer fixo só com medição: horta e timer somam só o que vem depois
    do início da medição (o dia do início conta pelas horas medidas);
    dias sem medição aparecem hachurados com "sem medição" no gráfico,
    sem barra de timer, e com "—" na tabela
    - ordem nova: frase grande ("A horta usou 2,5 L. Um timer fixo teria
    usado 45 L."), H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
2026-10-01 Histórico: decisões agrupadas e gráfico mais claro
    - Últimas decisões: 5 linhas; "Ver mais" traz mais 10 de cada vez (até
    50). Decisões seguidas iguais (mesmo código e motivo) viram uma linha
    com contador e intervalo ("· ×3 · 12:04–13:39"); "(simulado)" vira
    etiqueta; datas pelo tempo.js ("hoje 13:54", "seg 28 13:54")
    - no computador a lista não passa da altura do gráfico: rola por
    dentro, com o título preso no topo; no celular, sem limite
    - gráfico: linha embaixo do título com o dia e o intervalo ("ontem,
    14:41–14:48 · 50 leituras · uma a cada 30 s (10 s no modo teste)");
    legenda "Rega" só quando há rega no intervalo; rótulos das faixas
    no canto mais l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
2026-10-01 Planeje: tabela de culturas vai para a página Sobre
    - "Umidade e sol por cultura" sai do fim do Planeje sua horta (no
    celular a coluna de umidade ficava cortada) e vai para a página
    Sobre, gerada pelo sobre.js com os dados do culturas.js (nada
    duplicado), com a cor de cada planta
    - no celular, cada planta vira duas linhas (nome e umidade; sol
    embaixo), sem rolar para o lado
2026-10-01 Planeje: mapa fixo e etapas em abas
    - computador (≥ 900 px): o cartão do mapa fica preso à esquerda (~58%,
    altura da tela) e as etapas à direita (~42%), rolando sozinhas: o
    mapa nunca sai de vista
    - celular: o mapa fica preso no topo (~40% da tela, mínimo 220 px), as
    abas presas logo abaixo dele, e o botão "Recolher mapa" (para usar o
    teclado)
    - barra do mapa com duas chaves pequenas: Mapa | Desenho e Hoje |
    Verão | Inverno | Equinócio | Ano, mais o 📅 para outro dia; status e
    legenda numa linha embaixo do mapa; transparência só no modo Mapa
    - etapas em abas (abas.js): 1 Terreno · 2 Sombras · 3 Plantas · 4
    Salvar, com a aba no endereço (#terreno, #sombras, #pla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
2026-10-01 Planeje: canteiros com a cor da planta e rótulos sem sobreposição
    - o canteiro tem a cor da planta (a mesma da lista) nos dois modos, na
    planta PNG e na folha de impressão (com a cor e o número na tabela)
    - a avaliação vira um selo no canto: ✓ Recomendado, ! Aceitável, ✕ Não
    recomendado (cores dos NIVEIS); o aceitável também com a borda
    tracejada, para não depender só da cor
    - rótulos das plantas: o nome dentro do canteiro quando cabe; em
    canteiro pequeno, mapa estreito (< 500 px) ou se bater em outro
    rótulo, o número da planta na lista "Onde plantar" (ao lado, com uma
    linha, se o meio estiver ocupado)
    - rótulos dos obstáculos vêm depois (rotulos.js): no me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
2026-10-01 Planeje: escolha e lista das plantas
    - escolha agrupada pela necessidade de sol, com subtítulos (Pleno sol
    (6 h ou mais), 4 h de sol ou mais, Meia-sombra (3 a 6 h)); sai o
    "pleno sol (6 h ou mais)" repetido em cada linha
    - cada linha: caixa, cor e nome; a linha inteira marca (44 px de
    toque); a área só aparece com a planta marcada, junto da umidade
    ideal ("0,5 m² · solo 60–80%"); aceita "0,5" e "0.5"
    - "Onde plantar" com uma planta por linha: número (o mesmo do mapa),
    cor, nome, horas e lugar ("~6,5 h · canto noroeste") e o selo no fim
    - motivo claro quando não é recomendado: "~5 h em média, mas parte do
    canteiro passa de 6 h" (excesso, pelo maior valor do canteiro) o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
2026-10-01 Planeje: correções visuais
    - "Tamanho do terreno" e "Local": rótulo em cima e campo na largura da
    coluna (min-width: 0, width: 100%); os campos estouravam a caixa
    - botões desativados ("Voltar à sugestão") legíveis, sem a opacidade
    que apagava o texto
    - rosa dos ventos com o mesmo tamanho (48 px) e a mesma posição (canto
    de cima à direita, a 10 px) no Mapa e no Desenho
2026-10-01 Planeje: número das abas com 14 px
    - o círculo com o número da etapa (1 Terreno, 2 Sombras…) usa
    --fs-nota, como o resto do texto pequeno
2026-10-01 Site: README dos ajustes
    - O painel: variáveis de tamanho e clamp(), aba Agora cabendo em
    1366×768 e 1280×720, aviso de sem sinal com o tempo real
    - Água: período único (Desde o início · 7 dias · 30 dias), timer só
    com medição (dias sem medição fora da conta), bloco Hoje e Como
    calculamos
    - Histórico: decisões agrupadas, 5 linhas e "Ver mais"
    - Planeje: mapa fixo, etapas em abas com o endereço de cada uma
    (#terreno, #sombras, #plantas, #salvar), cor da planta no mapa, selos,
    números, escolha agrupada por sol; a tabela de culturas na página
    Sobre
    - arquivos novos: tempo.js, rotulos.js, plantas.js na lista; "Abrir
    pelo código" no lugar do antigo "Tenho um cód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
2026-10-01 Painel: densidade e encaixe no projetor
    - aba Agora cabe a 100% (área visível do navegador) em 1536×730 e
    1280×650, com e sem dados do ESP32
    - primeira fileira: faixa ~70% e QR ~30%, com a altura definida pela
    faixa; cartão do QR em linha (QR até 96 px, "Receba os alertas", a
    frase e o @ do canal), sem título em maiúsculas
    - números grandes com clamp(1.75rem, 2.6vw, 2.5rem); pílula da bomba e
    Automático/Manual com altura de botão médio (~36 px); clima em 2 × 2
    compacto (4 numa linha quando cabe) e "Atualizado ontem 14:38 · sem
    atualizar há 19 h" numa linha; cartões com 12–14 px de espaço e 12 px
    entre eles; unidades (%, °C, mm) com 14 px
    - notas dos cartõe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
2026-10-01 Planeje: uma horta, duas vistas
    Mapa e Desenho mostram o mesmo modelo (em metros, com referência
    geográfica opcional). Trocar de vista não recalcula nem perde canteiros.
    Hortas antigas (navegador, nuvem, link e backup) são migradas; o segundo
    desenho pode ser aberto como cópia. Aviso de conflito não dispara mais
    para o mesmo navegador. Alfinete para canteiros pequenos no mapa e textos
    novos da avaliação.
